makerspace-wi/RFID_Access/doc/Maschinen_RFID_CNC1.pdf

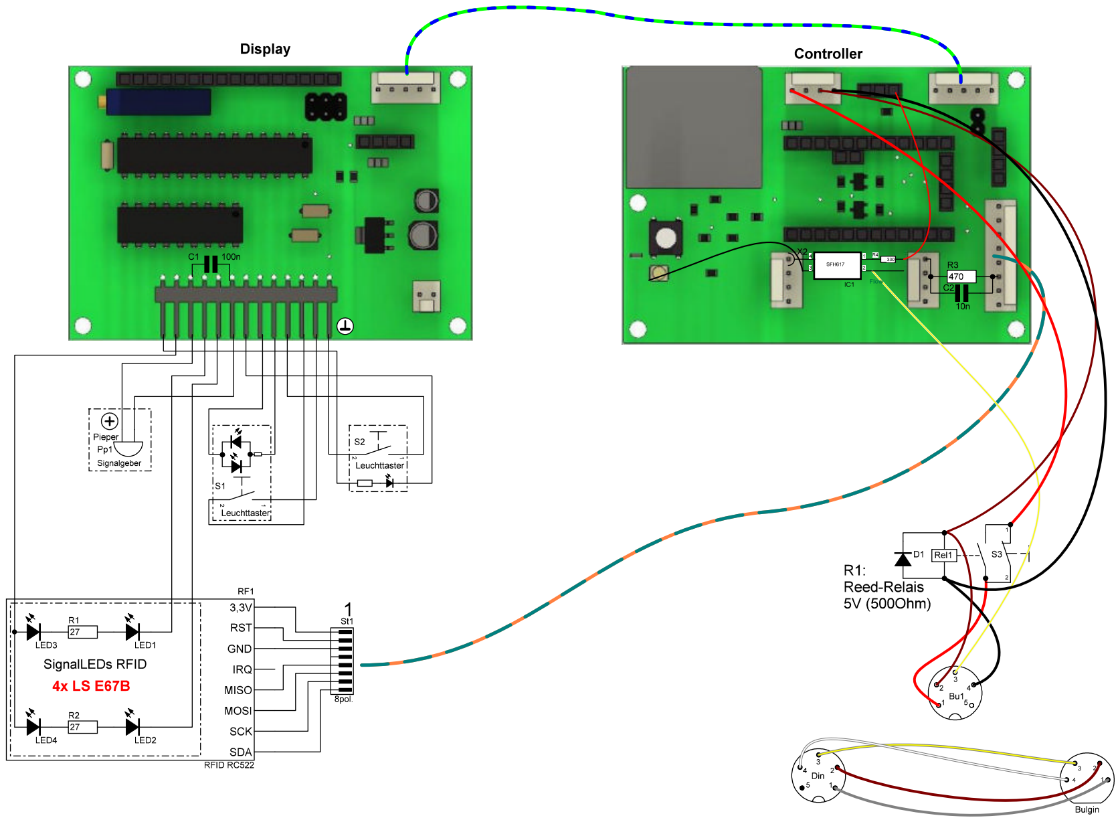
[picture p6: page 1]

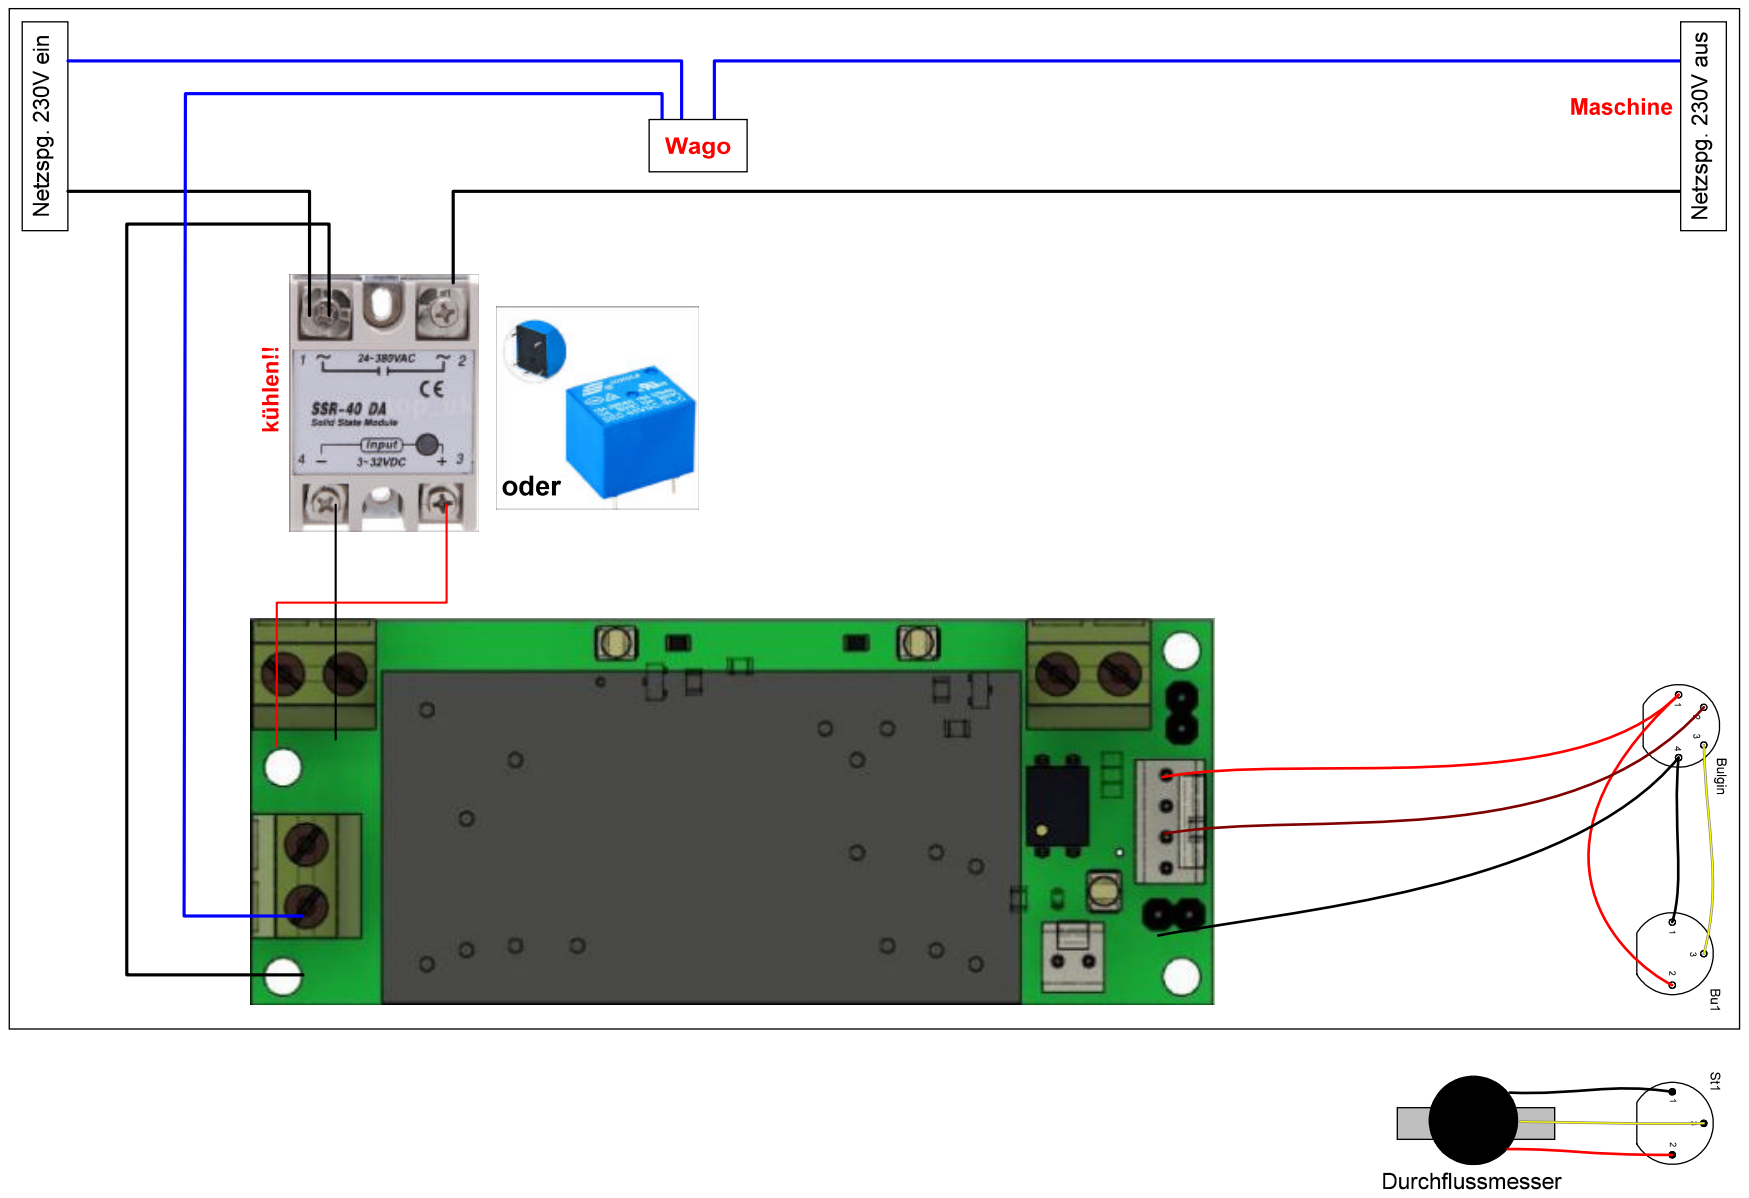
[picture p7: page 2]

Benennung K2 4polig K5 4polig | D-Sub | D-Sub Buchse Kabel
5V | 4 | rot | 1 | bn | sw
| | | 2 | rt | bn
| | | 3 | or | rt
A3 | 3 | orange | 4 | ge | or | Output Zusatz Input CNC1 Flowrate
A2 | 2 | braun | 5 | gn | ge | Output Gerät
Strom + | 1 | rt | 6 | bl | gn
GND | 1 | schwarz | 7 | li | rs
| | | 8 | gr | li
| | | 9 | sw | ws
Benennung K1 5polig K3 8polig | (Farbe) | D-Sub
5V | 5 | rot | 1
SCL | 4 | orange | 2
SDA | 3 | gelb | 3
SCK | 7 | blau | 4
MISO | 5 | gelb | 5
MOSI | 6 | grün | 6
SDA | 8 | violet | 7
RST | 2 | braun | 8
GND | 1 | schwarz | 9
