makerspace-wi/RFID_Access/doc/PCB_ACDC_SSR-SSR_V3.pdf

; Stückliste=D:\44_workspace\20_Schliesssystem_RFID\06_PCB\ACDC_SSR-SSR_V3.T3001
; Datum=20.September.2020 12:01
Pos Anzahl Name | Wert | Gehäuse | Pos Anzahl Name | Wert | Gehäuse
1 | 1 C1 | 100nF | 0805 | 12 | 1 K6 | DCDC 5V | Stiftleiste_1x02_G_2,54
2 | 1 C2 | 1nF | 0805 | 13 | 1 K7 | Eingang | SL-MTA/2.54/3POL
3 | 3 D1,D2,D4 LST676-Q1R2 | PLCC2 | 14 | 1 NT_MOD1 IRM-p-v | IRM-1-30W-xxV
4 | 1 D3 | MA2S111 | SOD523 | 15 | 3 R1,R4,R8 1K | 0805
5 | 1 IC1 | ATTINY45 (SFH610) DIL8 | 16 | 2 R2,R5 | 10K | 0805
6 | 1 J1 | Eing. | SSR2 | LÖTJUMPER 3-FACH 1,27 OPEN | 17 | 2 R3,R6 | 220 | 0805
7 | 1 K1 | 230V AC | ANSCHLUSSKLEMME_2 | 18 | 1 R7 | 0 (1K) | 0805
8 | 2 K2 ,K3 | SSR1 | ANSCHLUSSKLEMME_2 | 19 | 1 R9 | 470 (-) | 0805
10 | 1 K4 | DCDC GND | Stiftleiste_1x02_G_2,54 | 20 | 1 RC1 | 1xx | 0805
11 | 1 K5 | 5V, SSRs+ | SL-MTA/2.54/4POL | 21 | 2 T1,T2 | IRLML2502PBF SOT-23/3

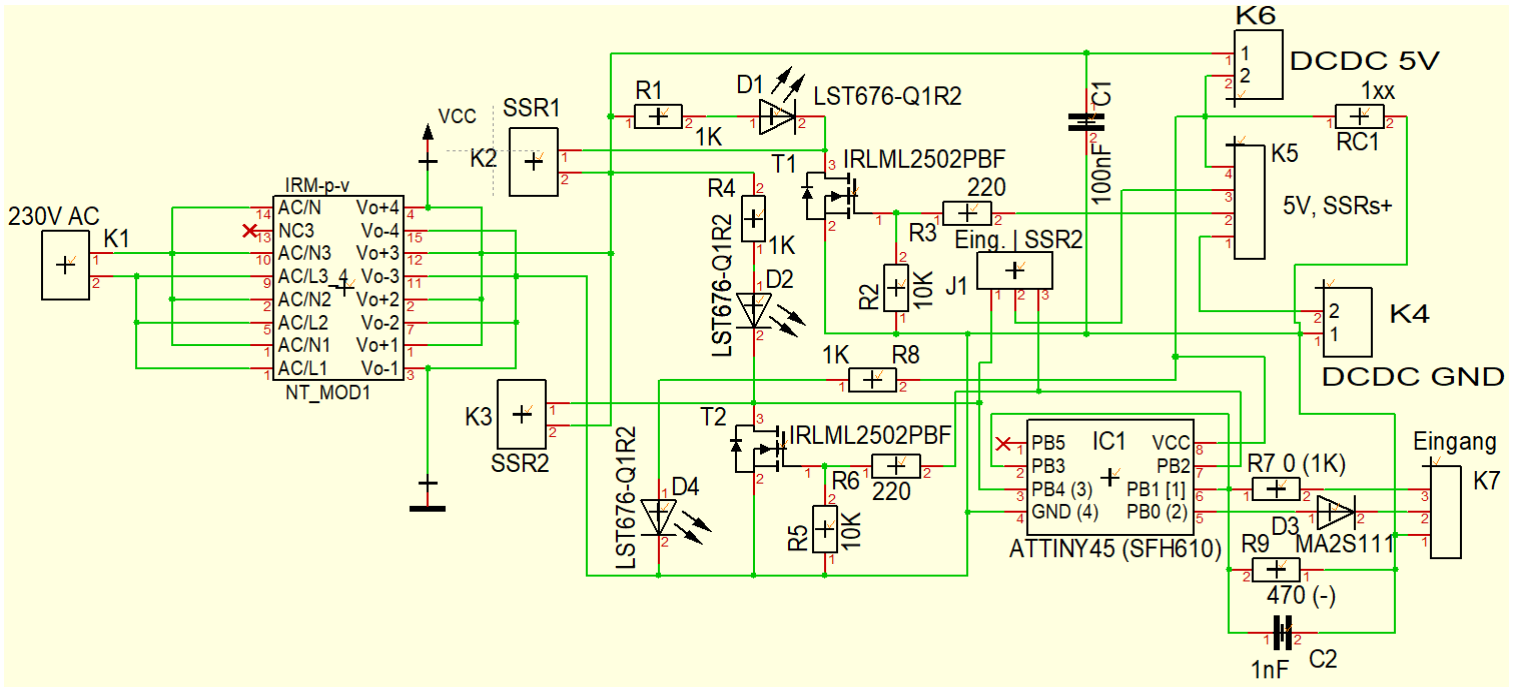
[picture p8: figure]

SSR1 | SSR2 230V AC

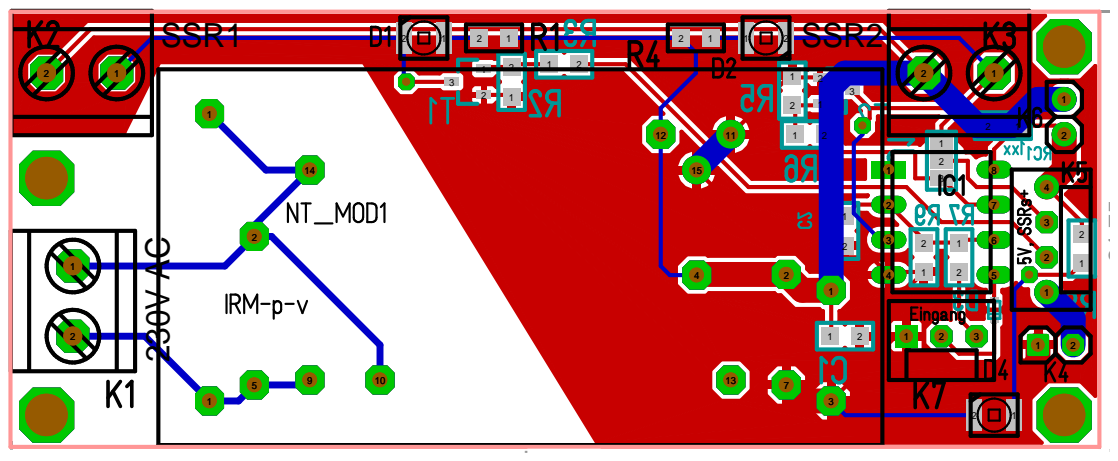
[picture p9: page 2]
