makerspace-wi/RFID_Access/doc/PCB_I2C_LED_Disp_V5.pdf

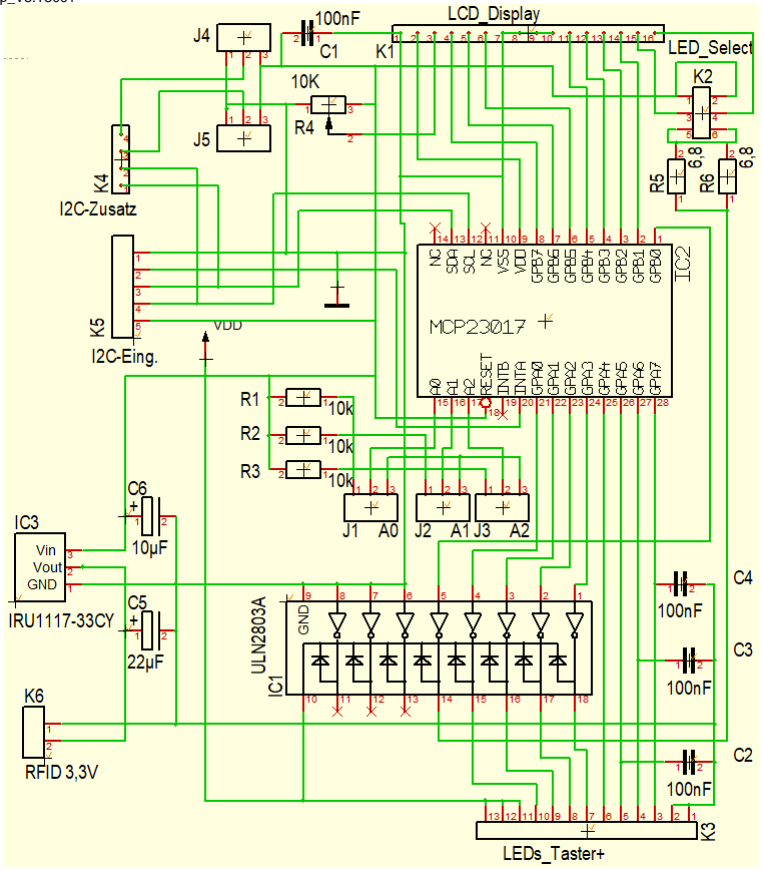
[picture p12: figure]

; Stückliste=D:\44_workspace\20_Schliesssystem_RFID\06_PCB\I2C_LED_Disp_V5.T3001 ; Datum=20.September.2020 23:04
Pos Anzahl Name | Wert | Gehäuse
1 | 4 | C1,C2,C3,C4 | 100nF | 3X5R5,08
2 | 1 | C5 | 22µF | SMD_R6X6_ELKO
3 | 1 | C6 | 10µF | SMD_R5X5_ELKO
4 | 2 | GND MP1,GND MP2 GND | LÖTPUNKT_SMD
5 | 1 | IC1 | ULN2803A | DIL18
6 | 1 | IC2 | MCP23017 | DIL28_WB7,62_P2,54
7 | 1 | IC3 | IRU1117-33CY SOT223
8 | 1 | J1,J2,J3 | A0 | LÖTJUMPER 3-FACH
11 | 2 | J4,J5 | OPEN | LÖTJUMPER 3-FACH
12 | 1 | K1 | LCD_Display | 1X16_BUCHSE
13 | 1 | K2 | LED_Select | Stiftleiste_2x03_G_2,54
14 | 1 | K3 | LEDs_Taster+ 1X13-90
15 | 1 | K4 | I2C-Zusatz | 1X04_BUCHSE
16 | 1 | K5 | I2C-Eing. | SL-MTA/2.54/5POL
17 | 1 | K6 | RFID 3,3V | SL-MTA/2.54/2POL
18 | 13 LP1 – LP13 | Lötpunkt_SMD LÖTPUNKT_SMD
19 | 3 | R1,R2,R3 | 10k | 0805
20 | 1 | R4 | 10K | POTI-TRIM_TCX7X
21 | 2 | R5,R6 | 6,8 | 0805

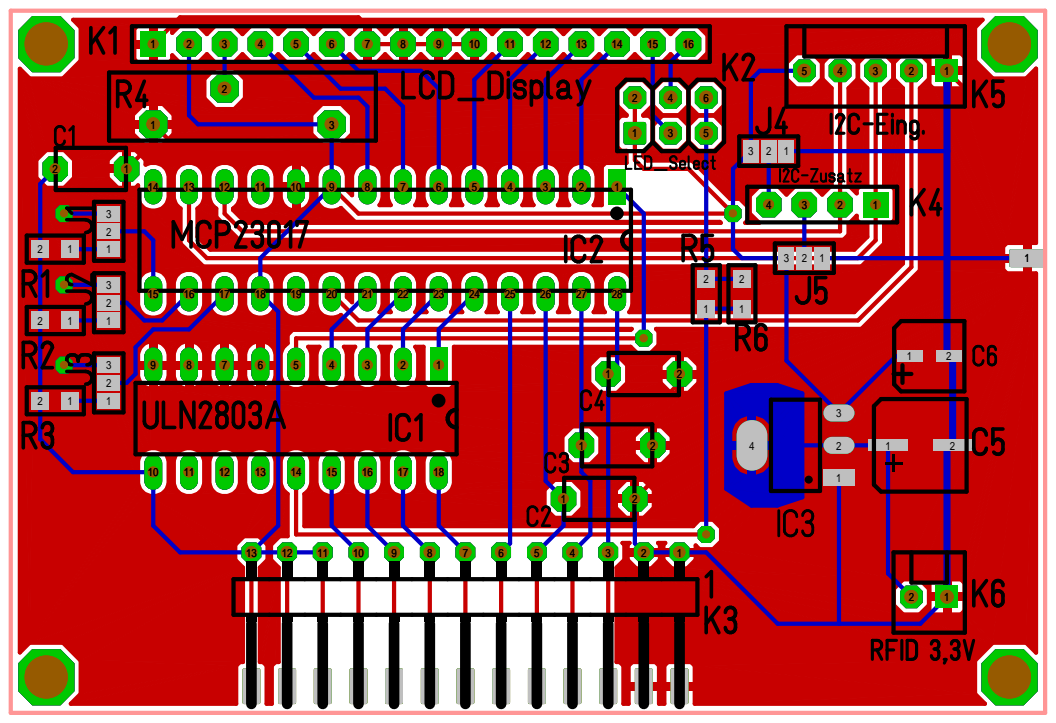
[picture p13: page 2]
