makerspace-wi/RFID_Access/src/RFID_Access.ino

/* DESCRIPTION
  ====================
  started on 01JAN2017 - uploaded on 06.01.2017 by Dieter
  Code for machine and cleaner control over RFID
  reading IDENT from xBee, retrait sending ...POR until time responds
  switch on claener by current control and separate cleaner on

  Commands to Raspi --->
  xBeeName - from xBee (=Ident) [max 4 caracter including numbers] {xBeeName + nn}
  'Ident;POR;Vx.x.x' - machine power on reset and sw version (Ident;por;Vx.x.x)
  'card;nn...'       - uid_2 from reader
  
  'Status:'
  'Ident;on'         - Ident is startet and time is on
  'Ident;off'        - Ident reporting nobody logged in
  'Ident;cmd?;'      - Ident reporting unknown command
  'Ident;Num?;'      - Ident reporting unkown number
  If current detection then:
  'cd_'    - current detected
  'nc_'    - no current
  'cule___'- current level for detection without unit [A]
  'flra___'- flowrate measured with unit [ml/min]

  Commands from Raspi (Commands send from raspi, are allways inspected and if known, executed!!!)
  'time'   - format time33.33.3333 33:33:33
  'noreg'  - RFID-Chip not registed
  'ontxx'  - Machine xxx minutes ON
  'onp'    - Machine permanent ON
  'off'    - Machine OFF
  'onDust' - Dust Collector on
  'ofDust' - Dust Collector off

  'setce'  - [15 min] set time before ClosE machine
  'setcn'  - [6 sec] set time for longer CleaN on
  'setcl'  - [0] set Current Level for switching on and off [CURLEV = current value / 3 * 2]
  'setsc'  - [0] set send current value active = 1
  'setfc'  - [0] set flowcontrol active = 1
  'setfm'  - [150] (ml/min) set flow minimum for maschine on
  'setrt'  - [1] set RepeaT messages
  'dison'  - display on for 30 secs
  'r3t...' - display text in row 3 "r3tabcde12345", max 20
  'r4t...' - display text in row 4 "r4tabcde12345", max 20

  last change: 24.02.2026 by Michael Muehl
  changed: update documentation, check boundary for current level setting

*/
#define Version "9.8.8" // (Test = 9.8.x ==> 9.8.9)
#define xBeeName   "MA" // Name and number for xBee
#define checkFA      2  // event check for every (1 second / FActor)
#define flowSend    12  // [12] x 10 sec send flowrate (2min)
#define flowMin    500  // [500] minimum flow for motor start in milliLiter/min
#define flowTol     25  // [25] warning signal start before flowMin
#define flowMeas    10  // [10] second measure time

#include <Arduino.h>
#include <TaskScheduler.h>
#include <Wire.h>
#include <LCDLED_BreakOUT.h>
#include <utility/Adafruit_MCP23017.h>
#include <SPI.h>
#include <MFRC522.h>

// PIN Assignments
// RFID Control -------
#define RST_PIN      4  // RFID Reset
#define SS_PIN      10  // RFID Select

// Machine Control (ext)
#define FLOWMETER    2  // input Flow Meter [INT0]
#define currMotor   A0  // Motor current (Machine)

#define OUT_Machine A2  // OUT Machine on / off  (Machine)
#define OUT_Dust    A3  // OUT Dust on / off  (Dust Collector)

#define xBuError     8  // xBee and Bus error (13)

// I2C IOPort definition
byte I2CFound = 0;
byte I2CTransmissionResult = 0;
#define I2CPort   0x20  // I2C Adress MCP23017 (LCD Display +)

// Pin Assignments Display (I2C LCD Port A/LED +Button Port B)
// Switched to LOW
#define FlashLED_A   0  // Flash LEDs oben
#define FlashLED_B   1  // Flash LEDs unten
#define buzzerPin    2  // Buzzer Pin
#define BUT_P1_LED   3  // not used
// Switched High - Low - High - Low
#define StopLEDrt    4  // StopLEDrt (LED + Stop-Taster)
#define StopLEDgn    5  // StopLEDgn (LED - Stop-Taster)
// switch to HIGH Value (def .h)
// BUTTON_P1         6  // not used
// BUTTON_P2         7  // StopSwitch
// BACKLIGHT for LCD-Display
#define BACKLIGHToff 0x0
#define BACKLIGHTon  0x1

// DEFINES
#define porTime        5 // [  5] wait seconds for sending Ident + POR
#define disLightOn    30 // [ 30] display light on for seconds
#define CLOSE2END     15 // [ 15] MINUTES blinking before activation is switched off
#define CLEANON        6 // [  6] TASK_SECOND dust collector on after current off
#define repMES         0 // [  0] repeat commands
#define periRead     100 // [100] ms read analog input for 50Hz (current)
#define currHyst      25 // [ 10] hystereses for current detection
#define currMean       3 // [  3] current average over ...
#define calibFactor  125 // [125] ml / Hz --> 16 [Hz] correlate with 2000 [mililiter / minute]

// CREATE OBJECTS
Scheduler r;
LCDLED_BreakOUT lcd = LCDLED_BreakOUT();
MFRC522 rfid(SS_PIN, RST_PIN);  // Create MFRC522 instance

// Callback methods prototypes
void checkXbee();        // Task connect to xBee Server
void Indication();       // Task to let LED blink
void Unlocktimer();      // Task to Unlock machine
void repeatMES();        // Task to repeat messages

void BuzzerOn();         // Task for Buzzer
void FlashDelay();       // Task to let LED blink
void DispOFF();          // Task to switch display off after time

void Current();          // current measurement and detection

void FlowMeasure();      // Task to calculate Flow Rate

// Functions define for C++
void OnTimed(long);
void flash_led(int);

// TASKS (CallBack)
Task tM(TASK_SECOND / 2, TASK_FOREVER, &checkXbee, &r);	         // 500ms main task
Task tR(TASK_SECOND / 2, 0, &repeatMES, &r);                     // 500ms repeat messages (set repMES for iterations > 0)
Task tU(TASK_SECOND / checkFA, TASK_FOREVER, &Unlocktimer, &r);  // 1000ms / checkFActor unlock timer
Task tB(TASK_SECOND * 5, TASK_FOREVER, &Indication, &r);         // 5000ms Indication for several events

Task tBU(TASK_SECOND / 10, 6, &BuzzerOn, &r);                    // 100ms 6x =600ms buzzer on for 6 times
Task tFD(1, TASK_ONCE, &FlashDelay, &r);                         // Flash Delay leds
Task tDF(1, TASK_ONCE, &DispOFF, &r);                            // display off after xx sec

// --- Current measurement --
Task tCU(TASK_SECOND / 2, TASK_FOREVER, &Current, &r);             // current measure
// --- or Flow measurement --
Task tFM(TASK_SECOND * flowMeas, TASK_FOREVER, &FlowMeasure, &r); // flow measure for flowMeas sec

// VARIABLES
unsigned long val;
unsigned int timer = 0;
bool onTime = false;
int minutes = 0;
bool timeToogle = false;
bool flowToogle = false;
unsigned long code;
byte atqa[2];
byte atqaLen = sizeof(atqa);
byte intervalRFID = 0;      // 0 = off; from 1 sec to 6 sec after Displayoff
// Cleaner Control
bool displayIsON = false;   // if display is switched on = true
bool isCleaner  = false;    // is cleaner under control (installed)
byte steps4push = 0;        // steps for push button action
unsigned int pushCount = 0; // counter how long push button in action

// Variables can be set externaly: ---
// --- on timed, time before new activation
unsigned int CLOSE = CLOSE2END; // RAM cell for before activation is off
bool firstCLOSE = false;        // only display message once
// --- for cleaning
unsigned int CLEAN = CLEANON; // RAM cell for Dust vaccu cleaner on after no current
unsigned int CURLEV = 0;      // RAM cell for detecting ON = > and OFF = > (CURLEV = 1. current value / 3 * 2)

// current measurement (cleaning on):
bool sendcur = 0;             // send current value active (1)
byte sendCurrMean = 0;        // counter for mean current to send
unsigned int currentMean =0;  // mean value for sending current
unsigned int currentVal =0;   // mean value over periodes
unsigned int currentMax =0;   // read max value
int currNR  = 0;              // number off machine with current detection
byte stepsCM = 0;             // steps for current measurement
byte countCM = 0;             // counter for current measurement

// Flow Sensor ---------------sensorInterrupt = 0;    // 0 = digital pin 2
boolean flowControl = false;  // flowcontrol for water cooling motors
unsigned int flSeCnt = 0;     // Counter for sending flowrate
unsigned int flowcnt = 0;     // Flowmeter Counter
unsigned int flowval = 0;     // Flowmeter Value
unsigned int flowRate = 0;    // represents milliLiter/minute
unsigned int flowLev = flowMin;      // Value for motor start in milliLiter/minute

// Serial with xBee
String inStr = "";      // a string to hold incoming data
String IDENT = "";      // identifier for remote access control
String SFMes = "";      // String send for repeatMES
byte co_ok = 0;         // count ok after +++ control AT sequenz
byte getTime = porTime;

// ======>  SET UP AREA <=====
void setup()
{
  //init Serial port
  Serial.begin(57600);  // Serial
  inStr.reserve(40);    // reserve for instr serial input
  IDENT.reserve(5);     // reserve for IDENT serial output

  // initialize:
  Wire.begin();         // I2C

  SPI.begin();          // SPI

  rfid.PCD_Init();      // Init MFRC522
  rfid.PCD_SetAntennaGain(rfid.RxGain_avg);

  // IO MODES
  pinMode(xBuError, OUTPUT);
  pinMode(OUT_Machine, OUTPUT);
  pinMode(OUT_Dust, OUTPUT);

  pinMode(FLOWMETER, INPUT_PULLUP);

  // Set default values
  digitalWrite(xBuError, HIGH); // turn the LED ON (init start)
  digitalWrite(OUT_Machine, LOW);
  digitalWrite(OUT_Dust, LOW);

  attachInterrupt(digitalPinToInterrupt(FLOWMETER), pulseCounter, FALLING);

  r.startNow();

  // Check if I2C _ Ports are avilable
  Wire.beginTransmission(I2CPort);
  I2CTransmissionResult = Wire.endTransmission();
  if (I2CTransmissionResult == 0)
  {
    I2CFound++;
  }
  // I2C Bus mit slave vorhanden
  if (I2CFound == 1)
  {
    lcd.begin(20, 4);    // initialize the LCD
    lcd.clear();
    lcd.pinLEDs(buzzerPin, LOW);
    lcd.pinLEDs(BUT_P1_LED, LOW);
    but_led(1);
    flash_led(1);
    dispRFID();
    tM.enable();         // xBee check
    Serial.print(F("+++")); //Starting the request of IDENT
  }
  else
  {
    tB.enable();  // enable Task Error blinking
    tB.setInterval(TASK_SECOND);
  }
}
// Setup End -----------------------------------

// TASK (Functions) ----------------------------
void checkXbee()  // check if xBee name is read out
{
  if (IDENT.startsWith(xBeeName) && co_ok == 2)
  {
    ++co_ok;
    tB.setCallback(retryPOR);
    tB.enable();
    digitalWrite(xBuError, LOW); // turn the LED off (Programm start)
  }
}

void retryPOR()   // wait until time string arrived
{
  tDF.restartDelayed(TASK_SECOND * disLightOn); // restart display light
  if (getTime < porTime * 5)
  {
    Serial.println(String(IDENT) + ";POR;V" + String(Version));
    ++getTime;
    tB.setInterval(TASK_SECOND * getTime);
    lcd.setCursor(0, 0); lcd.print(String(IDENT) + " ");
    lcd.setCursor(16, 1); lcd.print((getTime - porTime) * porTime);
  }
  else if (getTime == 255)
  {
    tR.setIterations(repMES);
    tM.setCallback(checkRFID);
    tM.enable();
    displayON();
  }
}

void checkRFID()  // wait until rfid token is recognized
{ // 500ms Tick
  if (rfid.PICC_IsNewCardPresent() && rfid.PICC_ReadCardSerial())
  {
    code = 0;
    firstCLOSE = false;
    for (byte i = 0; i < rfid.uid.size; i++) {
      code = ((code + rfid.uid.uidByte[i]) * 10);
    }
    if (!digitalRead(OUT_Machine))
    { // Check if machine is switched on
      flash_led(4);
      tFD.setCallback(&FlashDelay);
      tFD.restartDelayed(100);
      tDF.restartDelayed(TASK_SECOND * disLightOn);
    }
    Serial.println("card;" + String(code));
    // Display changes
    lcd.setCursor(5, 0); lcd.print(F("               "));
    lcd.setCursor(0, 0); lcd.print(F("Card# ")); lcd.print(code);
    displayON();
  }

  if (displayIsON && steps4push > 0)
  {
    tB.disable();   //  time == 0 and timed or Button
    digitalWrite(OUT_Dust, LOW);
    pushCount = 0;
    steps4push = 0;
    flash_led(1);
  }
}

void Unlocktimer() // switch off check for ontime
{   // 500ms Tick
  uint8_t buttons = lcd.readButtons();
  if (timer > 0)
  {
    if (timer / 120 < CLOSE)
    { // Close to end time reached
      timeToogle = !timeToogle;
      tB.disable();
      if (timeToogle)
      { // timeToogle GREEN Button LED
        but_led(1);
        flash_led(1);
      }
      else
      {
        but_led(3);
        flash_led(4);
      }
      if (!firstCLOSE)
      {
        lcd.setCursor(0, 0);
        lcd.print("Place Tag @ Reader");
        lcd.setCursor(0, 1);
        lcd.print("to extend Time      ");
        tB.disable();
        tM.enable();
        firstCLOSE = true;
      }
    }
    --timer;
    minutes = timer / (60 * checkFA);
    if (timer % (60 * checkFA) == 0)
    {
      char tbs[8];
      sprintf(tbs, "% 4d", minutes);
      lcd.setCursor(16, 3); lcd.print(tbs);
    }
  }
  if (timer == 0 && onTime && stepsCM >3) timer = 1;
  if (((timer == 0 && onTime) || buttons & BUTTON_P2) && stepsCM <=3)
  {   //  time == 0 and timed or Button
      onTime = false;
      shutdown();
  }
}

// Task repeatMES: ------------------------
void repeatMES()    // --repeat messages from machines 
{
  Serial.println(String(SFMes));
}

void Indication()  // --Blink if BUS Error
{
  digitalWrite(xBuError, !digitalRead(xBuError));
}

void FlashDelay()  // flash time for LEDS
{
  flash_led(1);
}

void DispOFF()    // switch display off and clear
{
  displayIsON = false;
  lcd.setBacklight(BACKLIGHToff);
  lcd.clear();
  but_led(1);
  flash_led(1);
}

void Current()    // Current measuremet
{ // 500ms Tick
  // detect current for switching
  currentMax = getCurrMax();
  if (sendcur)
  {
    currentMean = currentMean + currentMax;
    ++sendCurrMean;
    if (sendCurrMean >= 20)
    { // every 10 sec send
      Serial.println("CUR" + String(currNR) + ";" + String(currentMean / sendCurrMean));
      sendCurrMean = 0;
      currentMean = 0;
    }
  }
  // steps ------------------
  switch (stepsCM)
  {
    case 0:   // set level values to min
      CURLEV = currentMax + currHyst;
      if (digitalRead(OUT_Machine))
      {
        stepsCM = 1;
        countCM = 0;
      }
      break;
    case 1:   // current > level
      if (currentVal > CURLEV)
      {
        SFMes = "CD"+ String(currNR);
        Serial.println(SFMes);
        tR.restart();
        digitalWrite(OUT_Dust, HIGH);
        stepsCM = 2;
      }
      break;
    case 2:   // generate level for detecting on
      if (currentVal > CURLEV && countCM < currMean + 1)
      {
        ++countCM;
      }
      else if (countCM > currMean)
      {
        CURLEV = currentVal / 3 * 2;  // 2 / 3 measured current = level
        stepsCM = 3;
        countCM = 0;
        Serial.println(String(IDENT) + ";cule;" + String(CURLEV));
      }
      break;
    case 3:   // current > level
      if (currentVal > CURLEV)
      {
        SFMes = "CD"+ String(currNR);
        Serial.println(SFMes);
        tR.restart();
        digitalWrite(OUT_Dust, HIGH);
        stepsCM = 4;
      }
      break;
    case 4:   // wait for level less then level 3 times
      if (currentVal < CURLEV && countCM <= CLEAN * 2)
      {
        ++countCM;
        if (countCM >= CLEAN * 2) {
          stepsCM = 5;
          countCM = 0;
          break;
        }
      }
      else if (currentVal > CURLEV && countCM < CLEAN * 2)
      {
        countCM =0;
      }
      break;
    case 5:   // switch off clean after x sec later
      SFMes = "NC"+ String(currNR);
      Serial.println(SFMes);
      digitalWrite(OUT_Dust, LOW);
      stepsCM = 3;
      break;
  }
  currentVal = (currentVal + currentMax) / 2;
}

void FlowMeasure() // save counter value and calculate flowrate and show resulte after a time
{
  detachInterrupt(digitalPinToInterrupt(FLOWMETER));
  flowval = flowcnt;
  flowcnt = 0;
  attachInterrupt(digitalPinToInterrupt(FLOWMETER), pulseCounter, FALLING);
  // send flowRate to LCD
  flowRate = flowval * calibFactor / flowMeas; // result in ml/min [with measurement for 10 sec]
  char tbs[8];
  sprintf(tbs, "% 5d", flowRate);
  lcd.setCursor(10, 2); lcd.print("Flow:"); lcd.print(tbs);
  if (flowRate <= flowLev + flowTol)
  {
    tB.enable();
  }
  else
  {
   tB.disable();
   flash_led(1);
  }
  if (flSeCnt <= 0)
  {
    Serial.println(String(IDENT) + ";flra;" + String(flowRate));
    flSeCnt = flowSend;
  }
  flSeCnt--;
}
// END OF TASKS ---------------------------------

// FUNCTIONS ------------------------------------
int getNum(String strNum) // Check if realy numbers
{
  strNum.trim();
  for (byte i = 0; i < strNum.length(); i++)
  {
    if (!isDigit(strNum[i])) 
    {
      Serial.println(String(IDENT) + ";?;" + inStr + ";Num?;" + strNum);
      lcd.setCursor(0, 2); lcd.print(F("no mumber           "));
      lcd.setCursor(0, 3); lcd.print(F("logout and reset    "));
      return 0;
    }
  }
  return strNum.toInt();
}

void noact()
{ // no action
  digitalWrite(OUT_Machine, LOW);
  digitalWrite(OUT_Dust, LOW);
  tM.enable();
  BadSound();
  but_led(1);
  flash_led(1);
  tDF.restartDelayed(TASK_SECOND * disLightOn);
}

void OnTimed(long min)  // Turn on machine for nnn minutes
{
  onTime = true;
  timer = timer + min * (60 * checkFA);
  Serial.println(String(IDENT) + ";ont");
  char tbs[8];
  sprintf(tbs, "% 4d", timer / (60 * checkFA));
  lcd.setCursor(0, 3); lcd.print(F("Time left (min):")); lcd.print(tbs);
  granted();
}

void OnPerm(void) // Turn on machine permanently (VIP-Users only)
{
  onTime = false;
  Serial.println(String(IDENT) + ";onp");
  lcd.setCursor(0, 3); lcd.print("Press Stop to EXIT  ");
  granted();
}

void granted()  // Tag registered
{
  tM.disable();
  tDF.disable();
  tU.enable();
  if (flowControl)
  {
    flSeCnt = 0;
    tB.setCallback(errorFlow);
    tB.setInterval(TASK_SECOND);
  }
  else
  {
    tCU.enable();        // Current
    currentVal =0;
  }
  if ((!flowControl) || (flowControl && (flowRate > flowLev)))
  {
    digitalWrite(OUT_Machine, HIGH);
    if (flowControl)
    {
      lcd.setCursor(0, 2); lcd.print("Access by ");
    }
    else
    {
      lcd.setCursor(0, 2); lcd.print("Access granted      ");
    }
    but_led(3);
    flash_led(1);
    GoodSound();
    tR.disable();
  }
  else
  {
    onTime = false;
    switchOFF();
    lcd.setCursor(0, 2); lcd.print("Access?? ");
    lcd.setCursor(0, 3); lcd.print("Access off: Flow<500");
  }
}

void switchOFF(void)
{ // Switch off machine and stop
  tU.disable();
  timer = 0;
  but_led(2);
  digitalWrite(OUT_Machine, LOW);
  digitalWrite(OUT_Dust, LOW);
  tDF.restartDelayed(TASK_SECOND * disLightOn);
  BadSound();
  flash_led(1);
  tM.enable();    // added by DieterH on 18.10.2017
  Serial.println(String(IDENT) + ";off");
}

void shutdown(void) // Switch off machine and stop
{
  switchOFF();
  if (flowControl)
  {
    flSeCnt = 0;
  }
  else
  {
    tCU.disable();        // Current
    stepsCM = 1;
  }
  // Display change
  lcd.clear();
  lcd.setCursor(0, 0); lcd.print("System shut down at");
}

void pulseCounter() // count interupt pulses
{
  flowcnt++;
}

void but_led(int var)
{ // button led switching
  switch (var)
  {
    case 1: // LED rt & gn off
      lcd.pinLEDs(StopLEDrt, HIGH);
      lcd.pinLEDs(StopLEDgn, HIGH);
      break;
    case 2: // RED LED on
      lcd.pinLEDs(StopLEDrt, LOW);
      lcd.pinLEDs(StopLEDgn, HIGH);
      break;
    case 3: // GREEN LED on
      lcd.pinLEDs(StopLEDrt, HIGH);
      lcd.pinLEDs(StopLEDgn, LOW);
      break;
  }
}

void flash_led(int var)
{ // flash leds switching
  switch (var)
  {
    case 1:   // LEDs off
      lcd.pinLEDs(FlashLED_A, LOW);
      lcd.pinLEDs(FlashLED_B, LOW);
      break;
    case 2:
      lcd.pinLEDs(FlashLED_A, HIGH);
      lcd.pinLEDs(FlashLED_B, LOW);
      break;
    case 3:
      lcd.pinLEDs(FlashLED_A, LOW);
      lcd.pinLEDs(FlashLED_B, HIGH);
      break;
    case 4:
      lcd.pinLEDs(FlashLED_A, HIGH);
      lcd.pinLEDs(FlashLED_B, HIGH);
      break;
  }
}

void BuzzerOff()  // switch buzzer off
{
  lcd.pinLEDs(buzzerPin, LOW);
  tBU.setCallback(&BuzzerOn);
}

void BuzzerOn()   // switch buzzer on
{
  lcd.pinLEDs(buzzerPin, HIGH);
  tBU.setCallback(&BuzzerOff);
}

void BadSound(void) // generate bad sound
{   // added by DieterH on 22.10.2017
  tBU.setInterval(100);
  tBU.setIterations(6); // I think it must be Beeps * 2?
  tBU.setCallback(&BuzzerOn);
  tBU.enable();
}

void GoodSound(void) // generate good sound
{
  lcd.pinLEDs(buzzerPin, HIGH);
  tFD.setCallback(&BuzzerOff);
  tFD.restartDelayed(200);
}

void errorFlow()  // blinking on flow error
{
  if (!flowToogle) 
  {
    flash_led(2);
  }
  else
  {
    flash_led(3);
  }
  flowToogle = !flowToogle;
}

//  RFID ------------------------------
void dispRFID(void)
{
  lcd.print("Sys V" + String(Version).substring(0,3) + " starts at:");
  lcd.setCursor(0, 1); lcd.print(F("Wait Sync xBee:"));
}

void displayON()  // switch display on
{
  displayIsON = true;
  lcd.setBacklight(BACKLIGHTon);
  tB.disable();
  tM.enable();
  intervalRFID = 0;
}

/*Function: Sample for 100ms and get the maximum value from the SIG pin*/
int getCurrMax()
{
  int curValue;   //value read from the sensor
  int curMax = 0;
  uint32_t start_time = millis();
  while((millis()-start_time) < periRead)
  {
    curValue = analogRead(currMotor);
    if (curValue > curMax)
    {
      curMax = curValue; //record the maximum sensor value
    }
  }
  return curMax;
}
// End Funktions --------------------------------

// Funktions Serial Input (Event) ---------------
void evalSerialData()
{
  inStr.toUpperCase();
  if (inStr.startsWith("OK"))
  {
    if (co_ok == 0)
    {
      Serial.println(F("ATNI"));
      ++co_ok;
    }
    else
    {
      ++co_ok;
    }
  }
  else if (co_ok ==1  && inStr.length() == 4)
  {
    if (inStr.startsWith(xBeeName))
    {
      IDENT = inStr;
      currNR = inStr.substring(2).toInt();
      Serial.println(F("ATCN"));
    }
    else
    {
      lcd.setCursor(0, 2);
      lcd.print("?:" + inStr + ";not for:" + xBeeName); 
    }
  }
  else if (inStr.startsWith("TIME") && stepsCM <=3)
  { // time string arrived
    inStr.concat("                   ");     // add blanks to string
    lcd.setCursor(0, 1); lcd.print(inStr.substring(4,24));
    tB.setInterval(TASK_SECOND / 2);
    getTime = 255;
  }
  else if (inStr.startsWith("NOREG") && inStr.length() ==5)
  { // chip not registed
    lcd.setCursor(0, 2); lcd.print(F("Tag not registered  "));
    lcd.setCursor(0, 3); lcd.print(F("===> No access! <==="));
    noact();
  }
  else if (inStr.startsWith("ONT") && inStr.length() >= 4 && inStr.length() < 7) 
  {
    val = getNum(inStr.substring(3));
    if (val > 5) OnTimed(val);
  }
  else if (inStr.startsWith("ONP") && inStr.length() ==3)
  {
    OnPerm();
  }
  else if (inStr.startsWith("OFF") && inStr.length() ==3)
  {
    shutdown(); // Turn OFF Machine, only in case of emergency!
  }
  else if (inStr.startsWith("ONDUST") && inStr.length() ==6)
  {
    digitalWrite(OUT_Dust, HIGH);  
  }
  else if (inStr.startsWith("OFDUST") && inStr.length() ==6)
  {
    digitalWrite(OUT_Dust, LOW);  
  }
  else if (inStr.startsWith("SETCE") && inStr.length() >= 5 && inStr.length() < 8)
  { // set time before ClosE machine
    val = getNum(inStr.substring(5));
    if (val >= CLOSE2END) CLOSE = val;
  }
  else if (inStr.startsWith("SETCN") && inStr.length() >= 5 && inStr.length() < 8)
  { // set time for longer CleaN on
    val = getNum(inStr.substring(5));
    if (val >= CLEANON) CLEAN = val;
  }
  else if (inStr.startsWith("SETRT") && inStr.length() >= 5 && inStr.length() < 7)
  { // set repeat messages
    val = getNum(inStr.substring(5));
    tR.setIterations(val);
  }
  else if (inStr.startsWith("SETCL") && inStr.length() >= 5 && inStr.length() < 9)
  { // set Current Level for switching relais on and off
    val = getNum(inStr.substring(5));
    if (val > 0) CURLEV = val; // <= 999 (3 Digits)
  }
  else if (inStr.startsWith("SETSC") && inStr.length() == 6)
  { // active current send = true
    val = getNum(inStr.substring(5));
    if (inStr.substring(5) == "1") 
    {
      sendcur  = true;
    }
    else
    {
      sendcur  = false;
    }
  }
  else if (inStr.startsWith("SETFC") && inStr.length() == 6)
  { // active flow control = true
    val = getNum(inStr.substring(5));
    if (inStr.substring(5) == "1")
    {
      flowControl = true;
      flSeCnt = 0;
      flowcnt = 0;
      tFM.enable(); // flow measurement on
    }
    else
    {
      flowControl = false;
      tFM.disable(); // flow measurement off
      stepsCM = 0;
    }
  }
  else if (inStr.startsWith("SETFM") && inStr.length() >= 5 && inStr.length() < 8)
  { // set flow Level for flow is ok
    val = getNum(inStr.substring(5));
    if (val > 0) flowLev = (float)val;
  }
  else if (inStr.startsWith("DISON") && !digitalRead(OUT_Machine))
  { // Switch display on for disLightOn secs
    displayON();
  }
  else if (inStr.substring(0, 3) == "R3T" && inStr.length() > 3)
  {  // print to LCD row 3
    inStr.concat("                    ");     // add blanks to string
    lcd.setCursor(0,2);
    lcd.print(inStr.substring(3,23)); // cut string lenght to 20 char
  }
  else if (inStr.substring(0, 3) == "R4T" && inStr.length() >3)
  {  // print to LCD row 4
    inStr.concat("                    ");     // add blanks to string
    lcd.setCursor(0,3);
    lcd.print(inStr.substring(3,23));   // cut string lenght to 20 char  changed by MM 10.01.2018
  }
  else
  {
    Serial.println(String(IDENT) + ";cmd?;" + inStr);
    lcd.setCursor(0, 2); lcd.print(F("Unknown command     "));
    lcd.setCursor(0, 3); lcd.print(F("logout and reset    "));
    noact();
  }
  inStr = "";
}
// End Funktions Serial Input -------------------

// PROGRAM LOOP AREA ----------------------------
void loop()
{
  r.execute();
  if (Serial.available() > 0)
  {
    char inChar = (char)Serial.read();
    if (inChar == '\x0d')
    {
      evalSerialData();
      inStr = "";
    }
    else if (inChar != '\x0a')
    {
      inStr += inChar;
    }
  }
}
