makerspace-wi/RFID_Access/(commit log)

2019-01-28 changed output polarity for red and green led: LOW = led on
2019-01-28 some changes of comment and switch button led off, when display light goes off
2019-02-06 changed current control for blower, level setting
2019-08-26 Correction of some bucks
    [RFID_Access.ino]
2019-11-05 Changed error blinking from blastgate (6-9)
    [RFID_Access.ino]
2019-12-29 Repeat time for RFID read fix to 500ms
    [RFID_Access.ino]
2020-01-03 Add some reset at 'noreg'
    [RFID_Access.ino]
2020-09-21 Add new documents for 3 PCBs with parts list
2022-01-18 Add new document for machines
    New version for power switch for new dust collektor K200
2022-03-01 Add switching dust collector
    over IP Symcon
2022-05-15 Changed wrong parameter for switching off access
    [RFID_Access.ino]
2022-11-08 new current and flow mesurement added
2022-11-09 adapt flow measurement to low flowrate
2022-11-09 change error message by numbers
    [RFID_Access.ino]
2022-11-12 show flowrate faster after stop
2023-05-31 Update RFID_Access.ino
    disable Flowmeter interrupt
2023-06-04 update code for flow
2023-08-24 Show message on display if wrong xBee name
    [RFID_Access.ino]
2025-10-28 add show current every 10sec
2026-02-24 update documentation
    update documentation, check boundary for current level setting
